JuanGrados/personal-website/content/projects/smart_manifold_controller/media/cover.jpeg

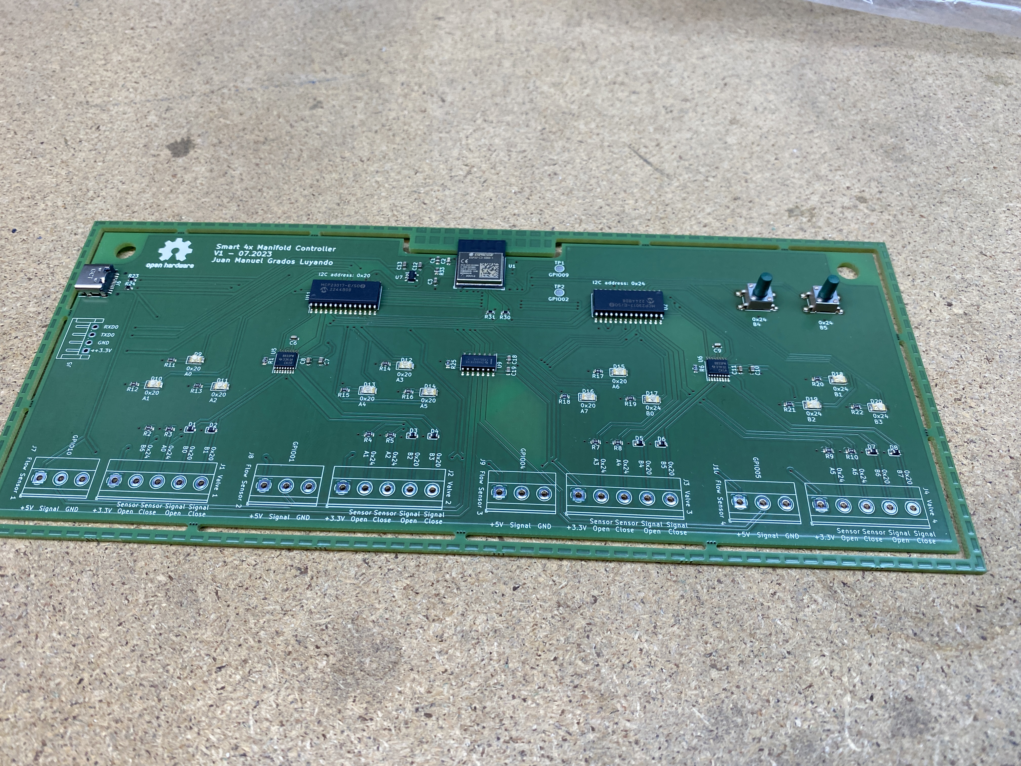
content/projects/smart_manifold_controller/media/cover.jpeg
