JuanGrados/personal-website/content/projects/smart_manifold_controller/media/pcb_comparison.jpeg

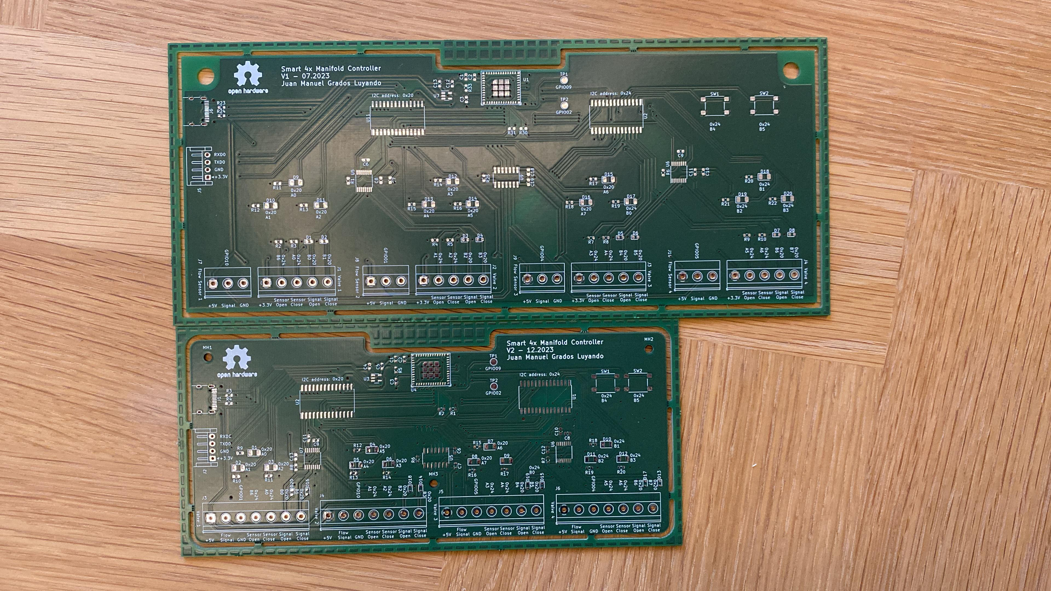
content/projects/smart_manifold_controller/media/pcb_comparison.jpeg
