JuanGrados/personal-website/content/projects/smart_manifold_controller/media/pcb_design.png

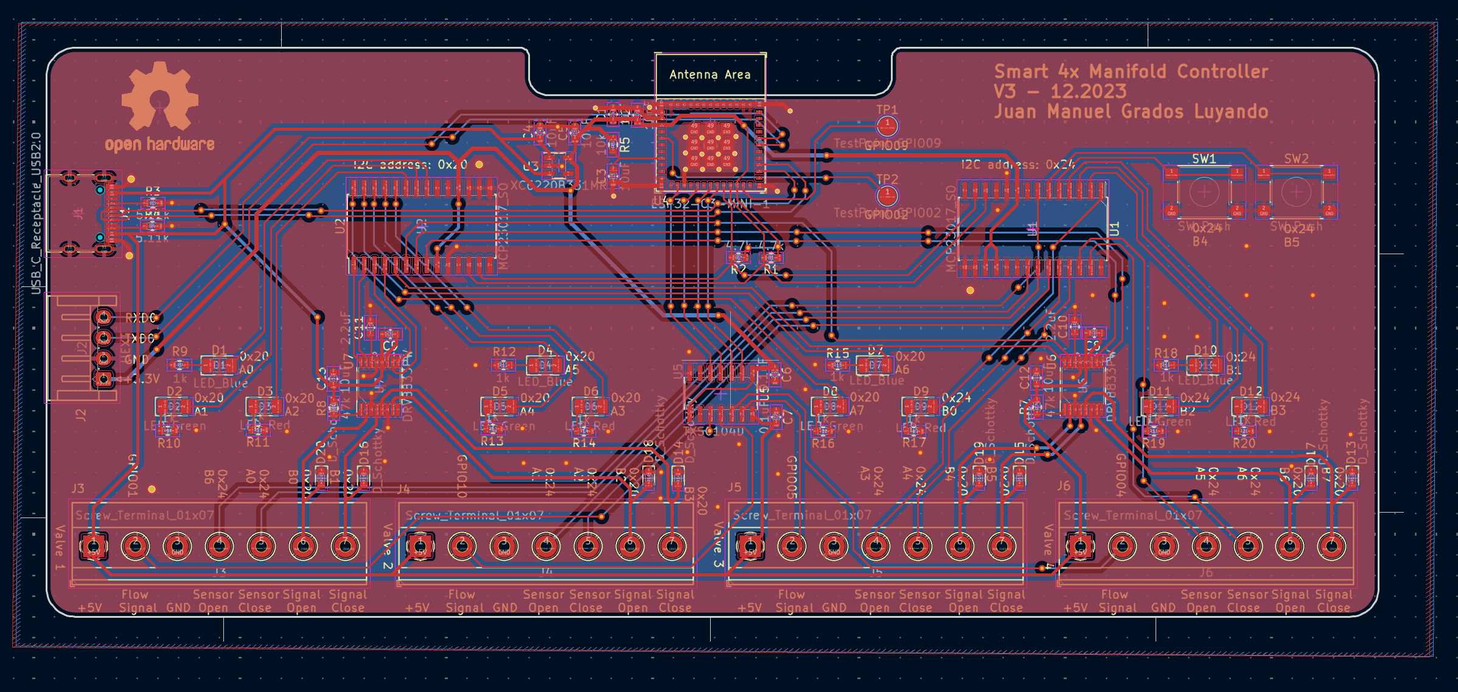
content/projects/smart_manifold_controller/media/pcb_design.png
