JuanGrados/personal-website/content/projects/smart_manifold_controller/media/box.stl

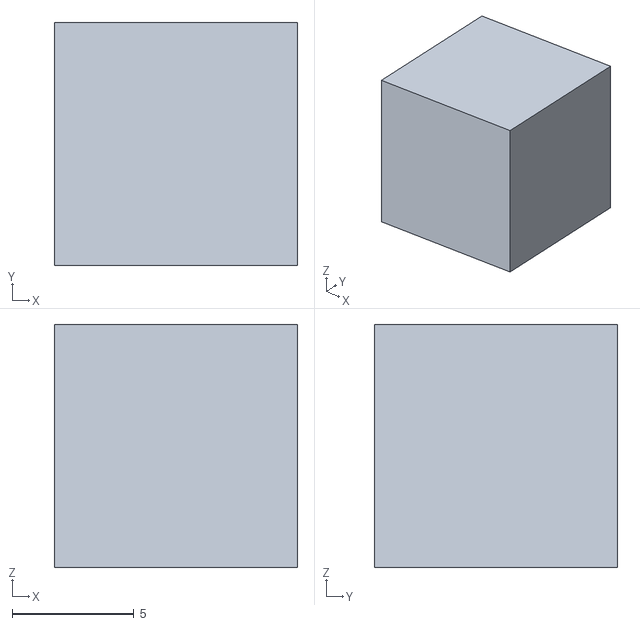
[picture p10: CAD file, 2025-12-25]
content/projects/smart_manifold_controller/media/box.stl
10.0 x 10.0 x 10.0
