JuanGrados/personal-website/content/projects/smart_manifold_controller/media/schematic.pdf

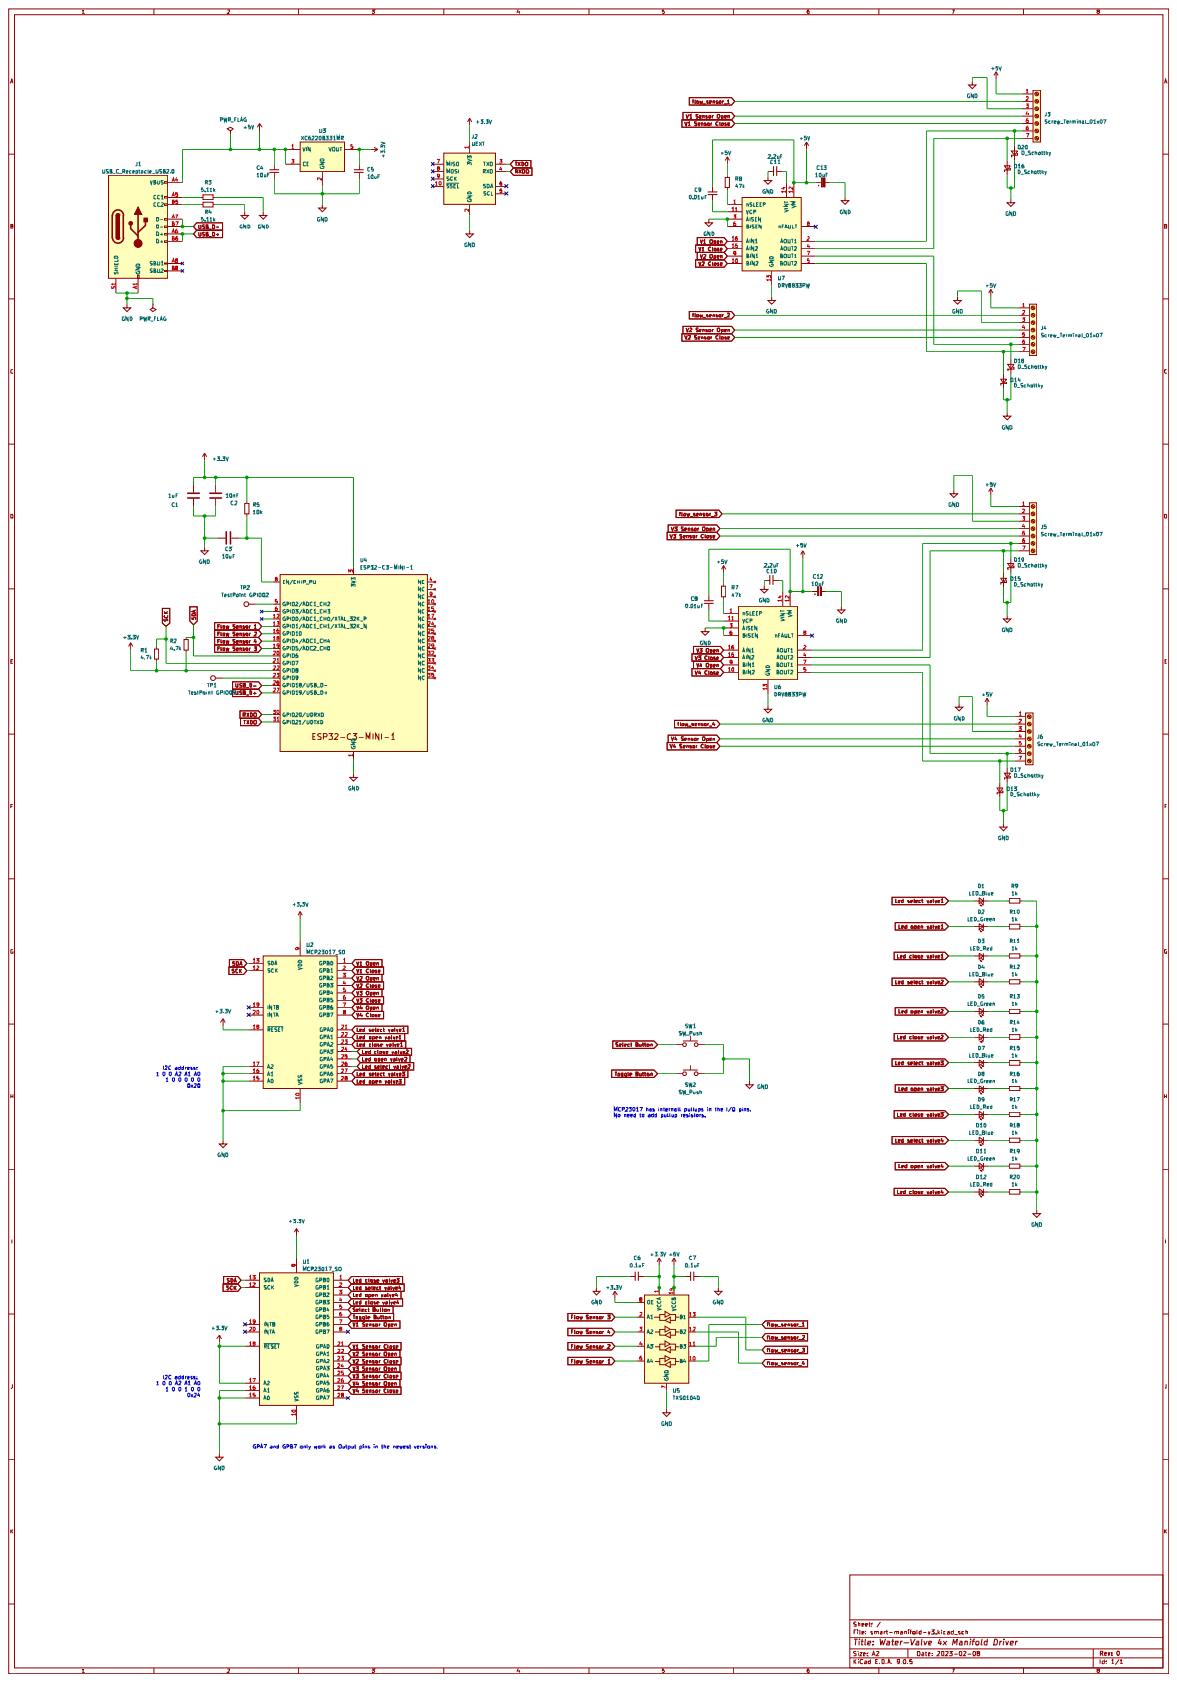
[picture p11: page 1]
