JuanGrados/personal-website/content/projects/smart_manifold_controller/media/usbc_solder.jpeg

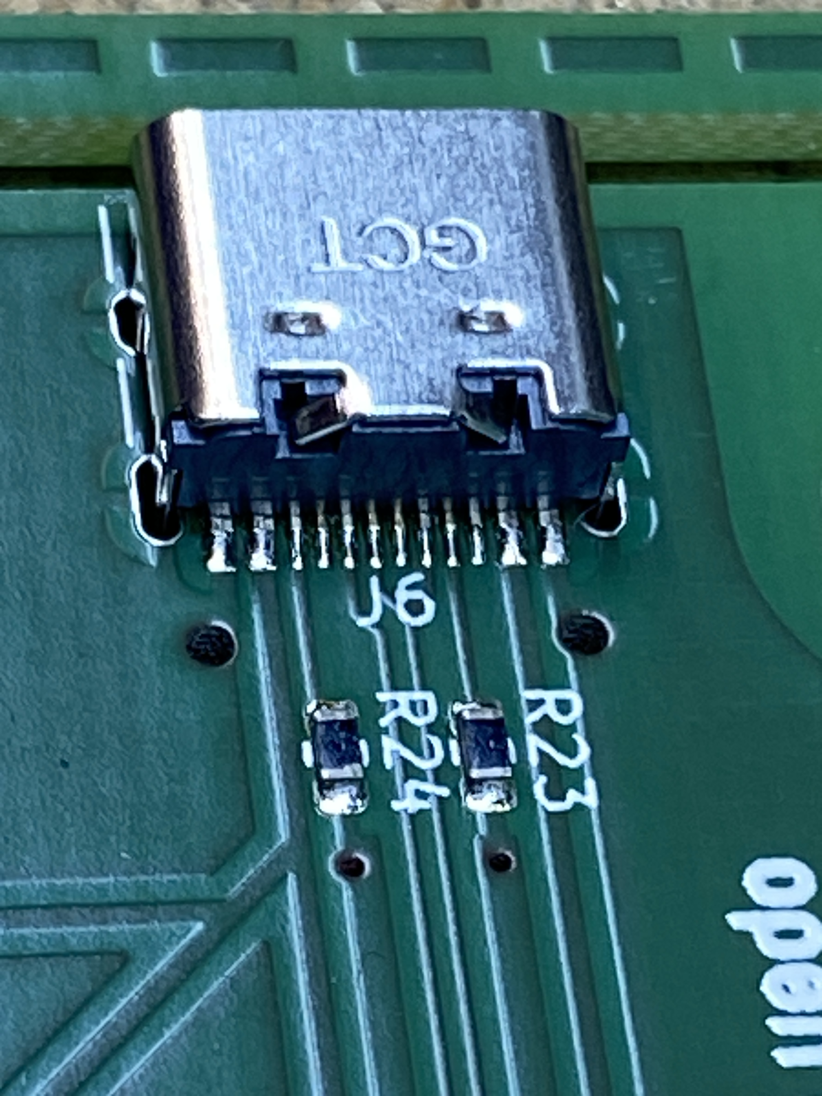
content/projects/smart_manifold_controller/media/usbc_solder.jpeg
