JuanGrados/personal-website/content/projects/smart_manifold_controller/media/cabinet_1.jpeg

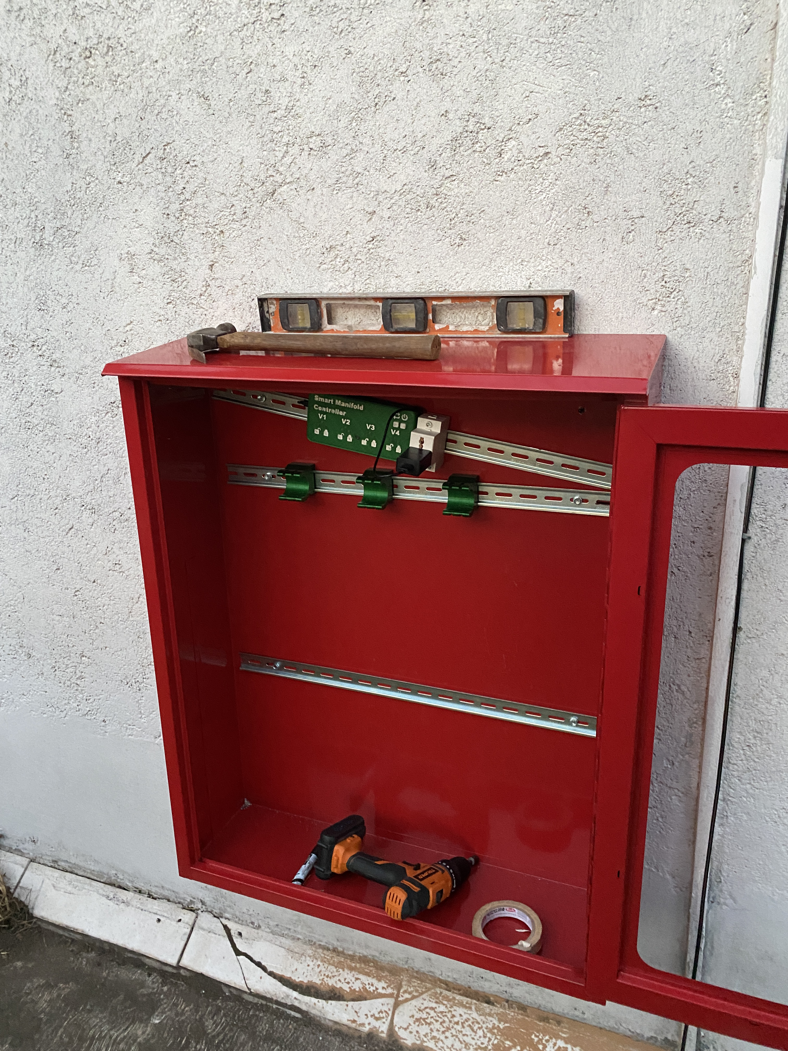
content/projects/smart_manifold_controller/media/cabinet_1.jpeg
