JuanGrados/personal-website/content/projects/smart_manifold_controller/media/final_installation_3.jpeg

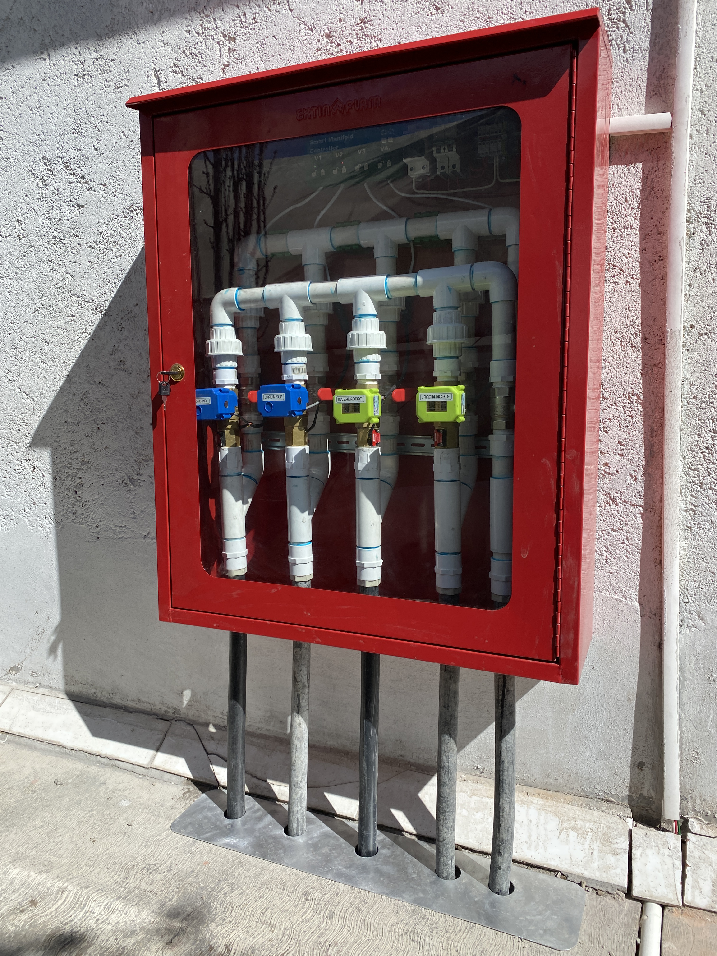
[picture p1: content/projects/smart_manifold_controller/media/final_installation_3.jpeg]
content/projects/smart_manifold_controller/media/final_installation_3.jpeg
