JuanGrados/personal-website/content/projects/smart_manifold_controller/media/valves_type_2.jpeg

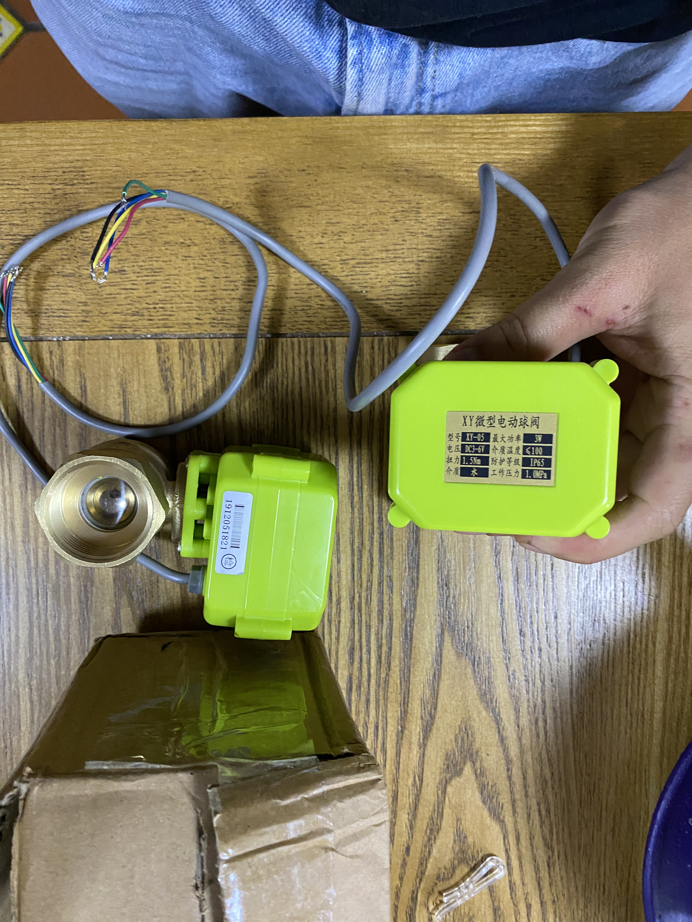
[picture p3: content/projects/smart_manifold_controller/media/valves_type_2.jpeg]
content/projects/smart_manifold_controller/media/valves_type_2.jpeg
